PDCLeska/Backgammon/art/olive.png

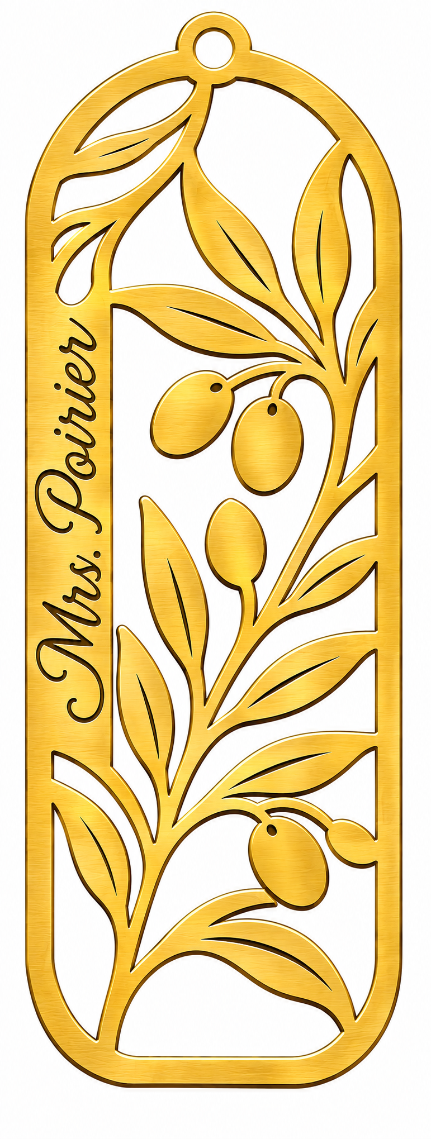
art/olive.png
