PDCLeska/Backgammon/art/sunflower.png

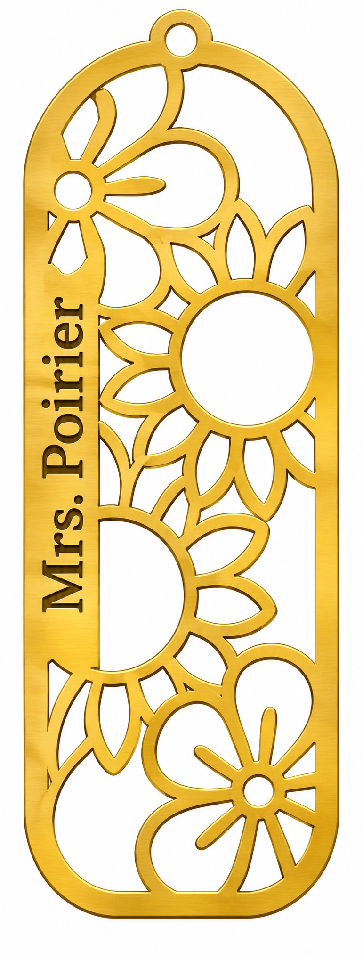
art/sunflower.png
