PDCLeska/Backgammon/art/back_map.png

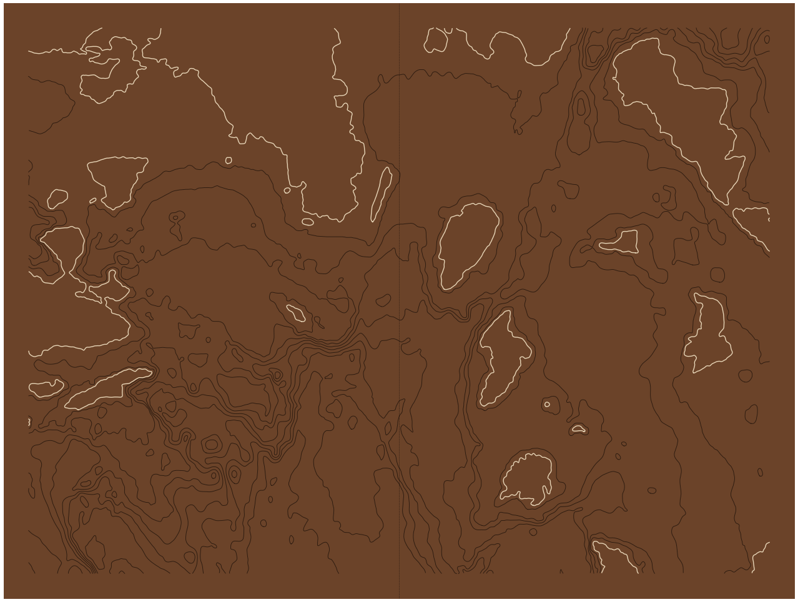
art/back_map.png
