PDCLeska/Backgammon/art/bookmark.png

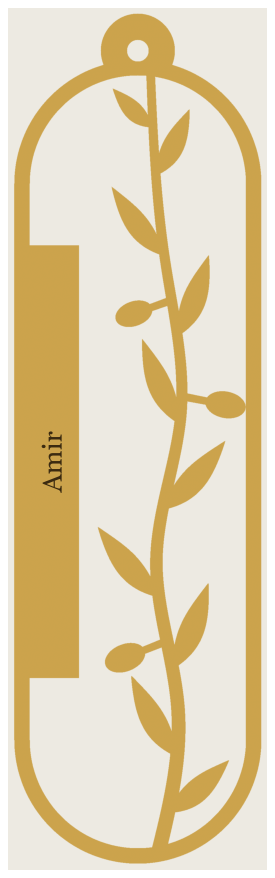
art/bookmark.png
