PDCLeska/Backgammon/art/chamfer_offset.png

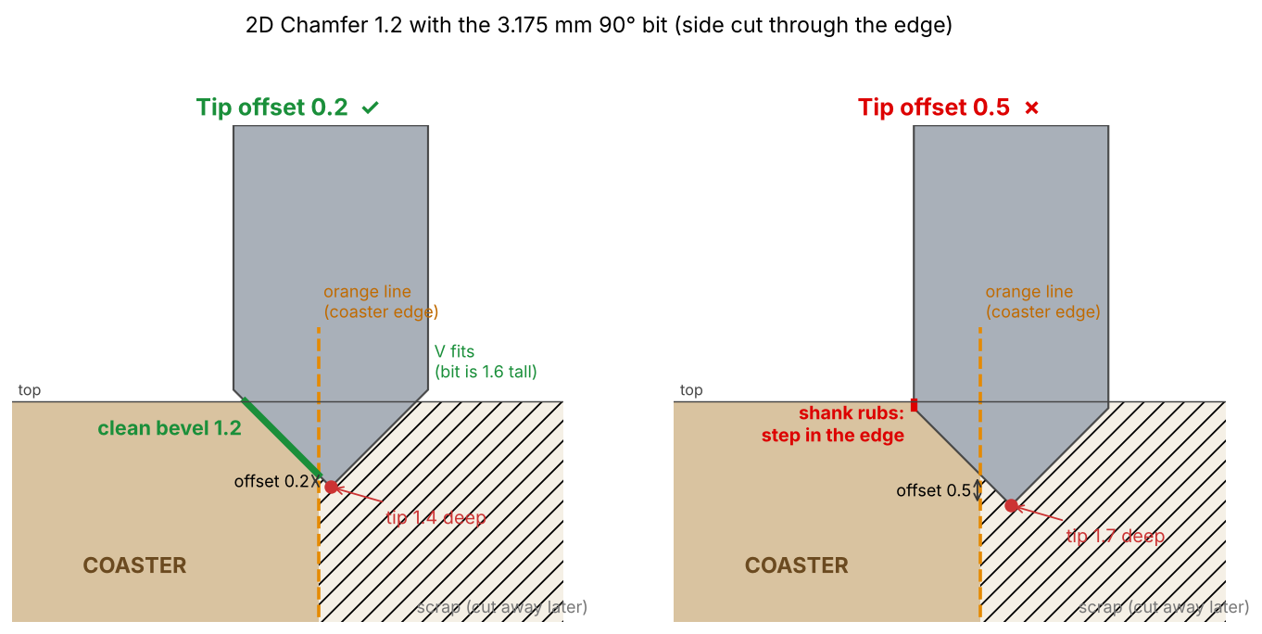
art/chamfer_offset.png
