PDCLeska/Backgammon/art/coaster_map.png

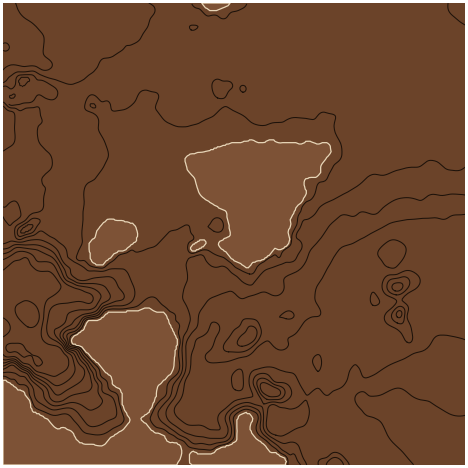
art/coaster_map.png
