PDCLeska/Backgammon/art/pintest.png

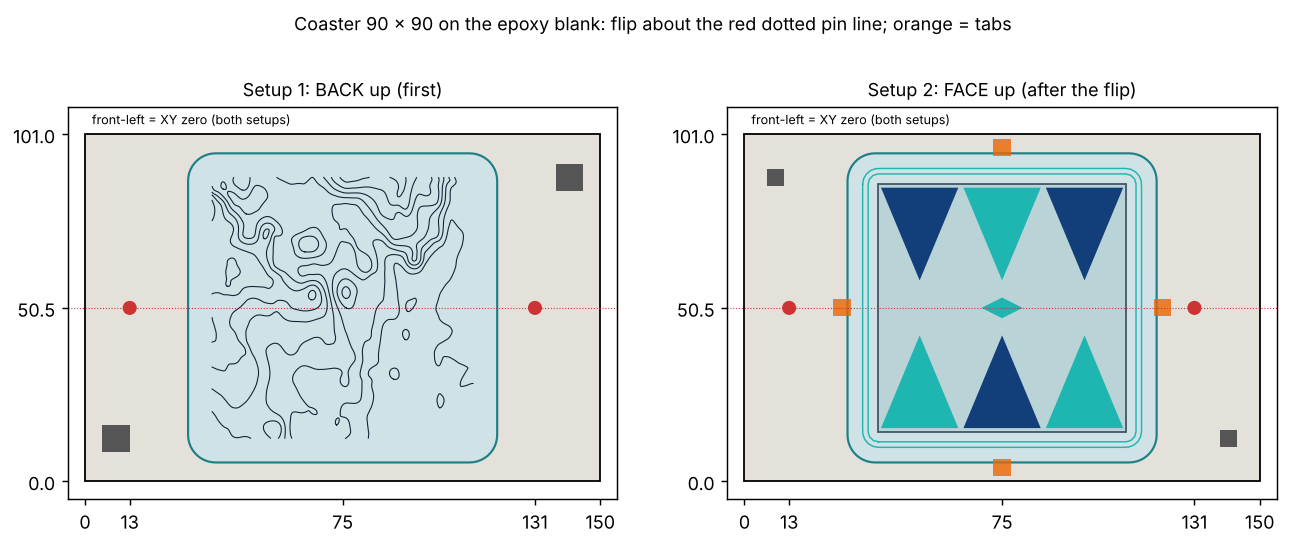
art/pintest.png
