PDCLeska/Backgammon/export/bookmarks/sunflower_on_plate.png

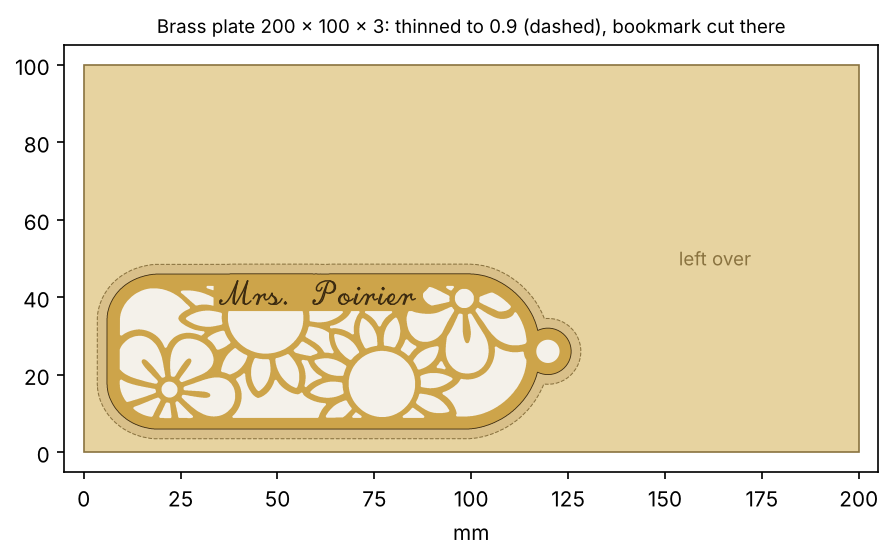
export/bookmarks/sunflower_on_plate.png
