PDCLeska/Backgammon/export/bookmarks/bookmark_sunflower.step

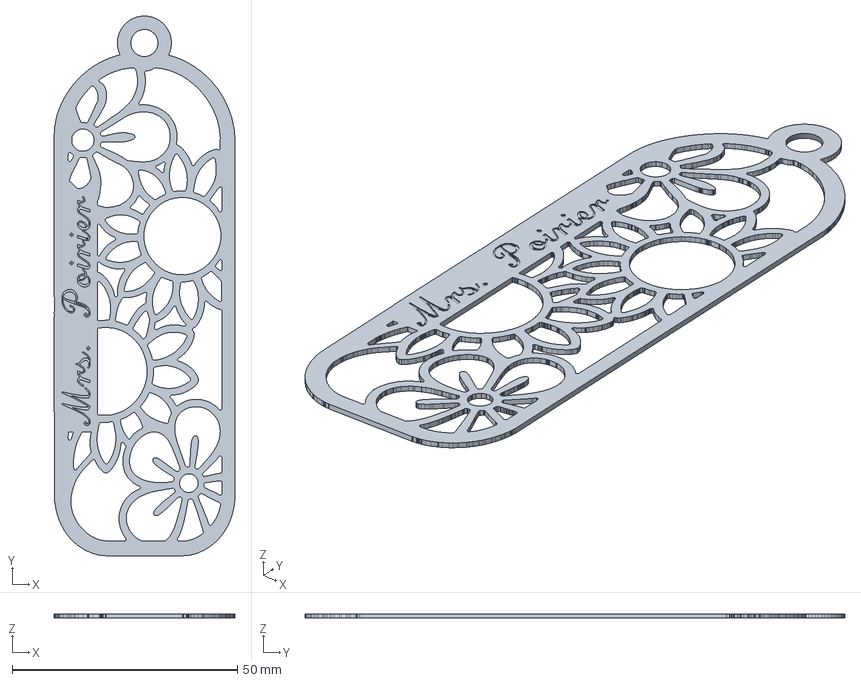
[picture p9: CAD file, 2026-11-07]
export/bookmarks/bookmark_sunflower.step
40.1 x 119.8 x 0.9 mm
