PDCLeska/Backgammon/export/pintest.step

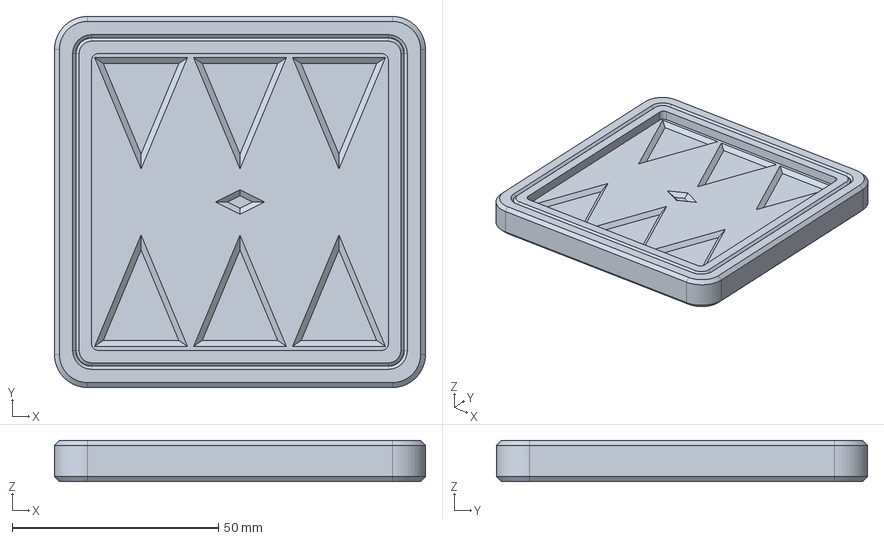
[picture p10: CAD file, 2026-11-07]
export/pintest.step
90.0 x 90.0 x 10.0 mm
