PDCLeska/Backgammon/export/bookmarks/sunflower_on_plate.dxf

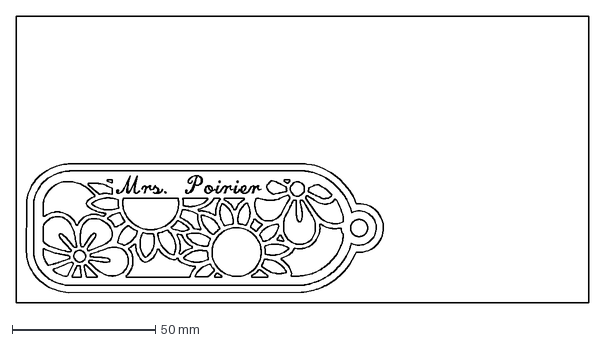
[picture p11: CAD file, 2026-11-07]
export/bookmarks/sunflower_on_plate.dxf
200.0 x 100.0 mm
