PDCLeska/Backgammon/export/pintest_2_face.dxf

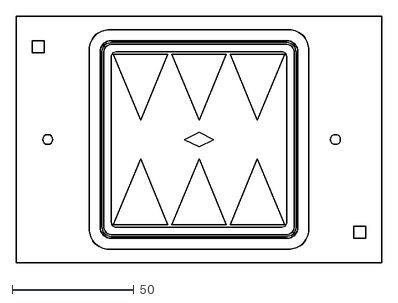
[picture p12: CAD file, 2026-11-07]
export/pintest_2_face.dxf
150.0 x 101.0
