PDCLeska/Backgammon/export/pintest_1_back.dxf

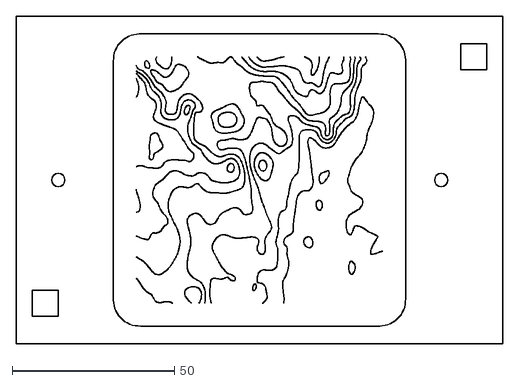
[picture p13: CAD file, 2026-11-07]
export/pintest_1_back.dxf
150.0 x 101.0
