PDCLeska/Backgammon/export/pintest_pins.dxf

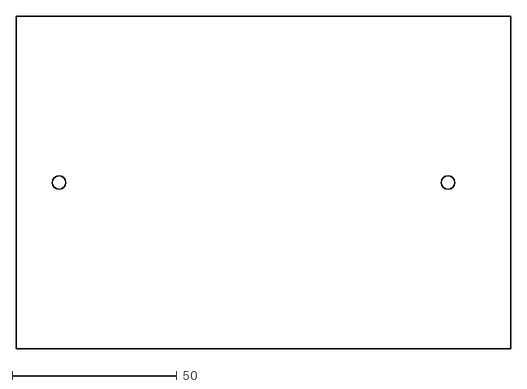
[picture p14: CAD file, 2026-11-07]
export/pintest_pins.dxf
150.0 x 101.0
