PDCLeska/Backgammon/export/bookmark.step

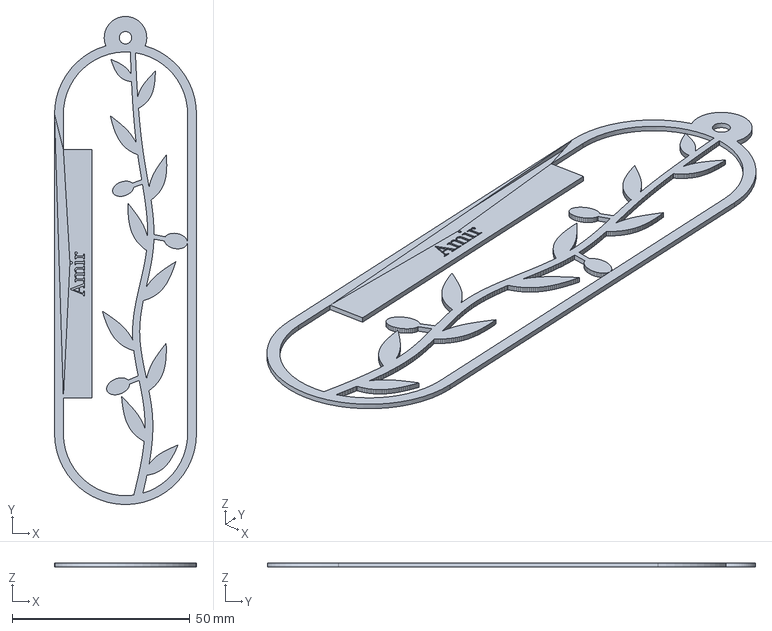
[picture p15: CAD file, 2026-11-07]
export/bookmark.step
40.0 x 137.5 x 1.00 mm
