PDCLeska/Backgammon/export/coaster_back.dxf

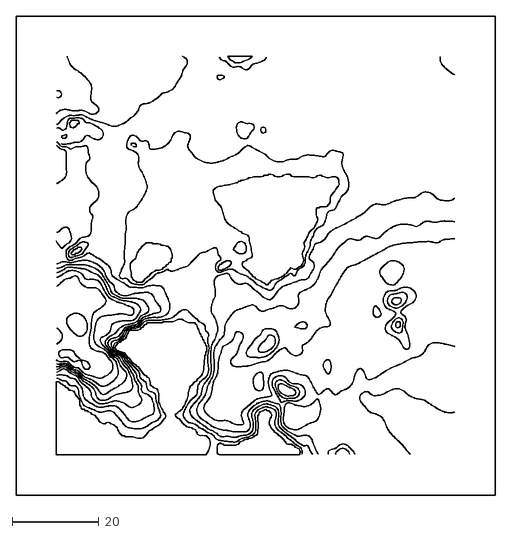
[picture p16: CAD file, 2026-10-28]
export/coaster_back.dxf
110.5 x 110.5
