PDCLeska/Backgammon/export/coaster.step

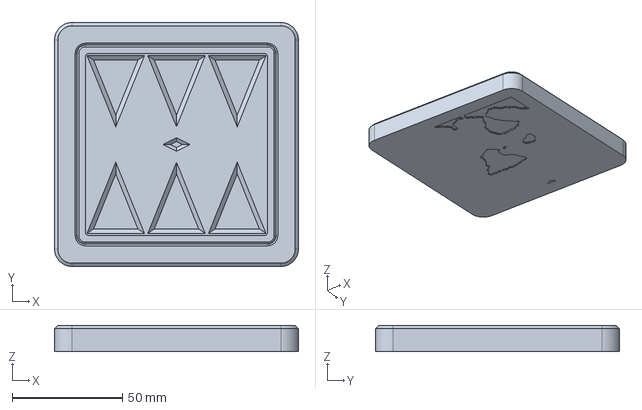
[picture p17: CAD file, 2026-10-28]
export/coaster.step
110.5 x 110.5 x 12.0 mm
