PDCLeska/Backgammon/export/coaster_top.dxf

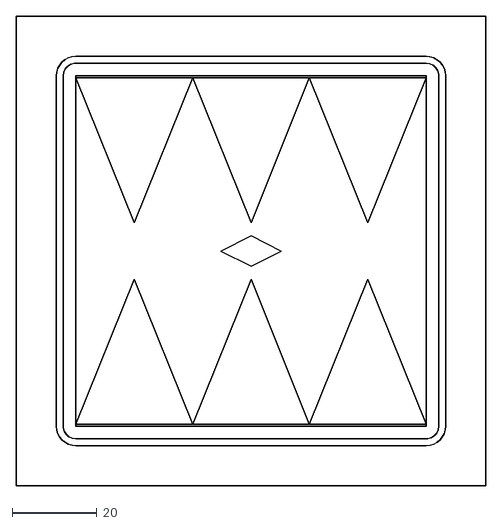
[picture p18: CAD file, 2026-10-28]
export/coaster_top.dxf
110.5 x 110.5
