PDCLeska/Backgammon/export/bg_back_left.dxf

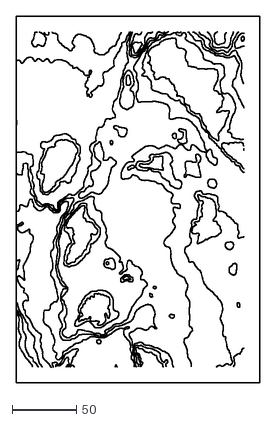
[picture p19: CAD file, 2026-10-28]
export/bg_back_left.dxf
190.0 x 286.0
