PDCLeska/Backgammon/export/bg_back_right.dxf

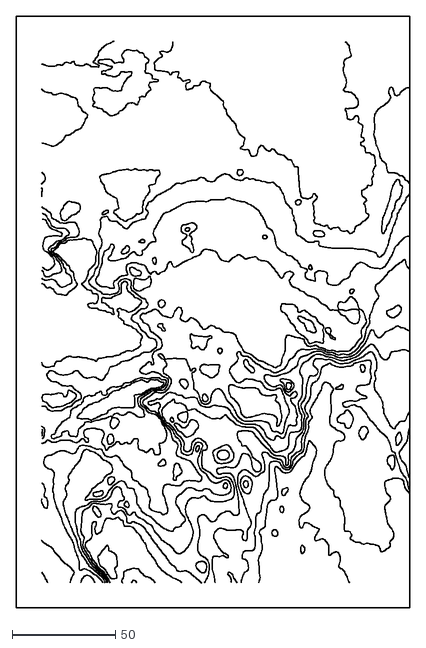
[picture p20: CAD file, 2026-10-28]
export/bg_back_right.dxf
190.0 x 286.0
