PDCLeska/Backgammon/export/bg_checker.step

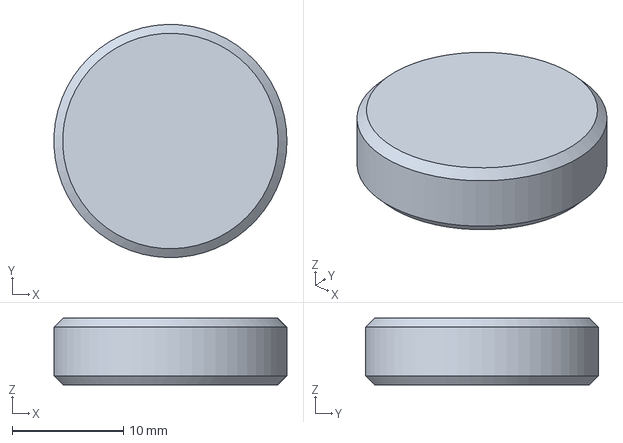
[picture p21: CAD file, 2026-10-28]
export/bg_checker.step
21.0 x 21.0 x 6.00 mm
