PDCLeska/Backgammon/export/bg_points_left.dxf

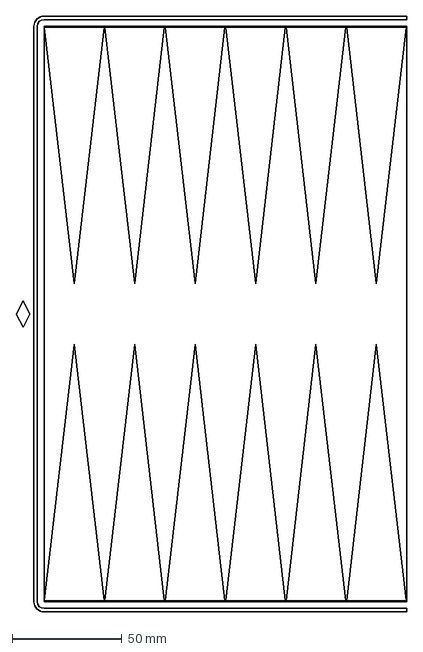
[picture p22: CAD file, 2026-10-28]
export/bg_points_left.dxf
177.6 x 271.2 mm
