PDCLeska/Backgammon/export/bg_half_right.step

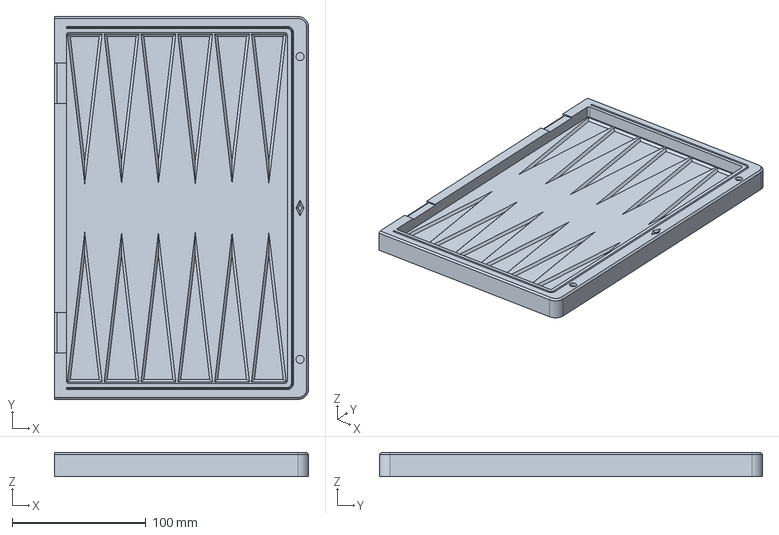
[picture p23: CAD file, 2026-10-28]
export/bg_half_right.step
190.0 x 286.0 x 18.0 mm
