PDCLeska/Backgammon/export/bg_points_right.dxf

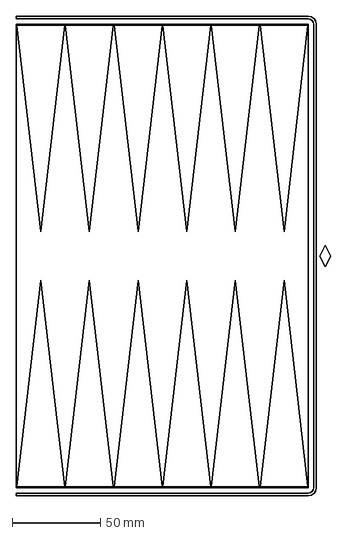
[picture p24: CAD file, 2026-10-28]
export/bg_points_right.dxf
177.6 x 271.2 mm
