PDCLeska/Backgammon/export/bg_inlay_sheet.dxf

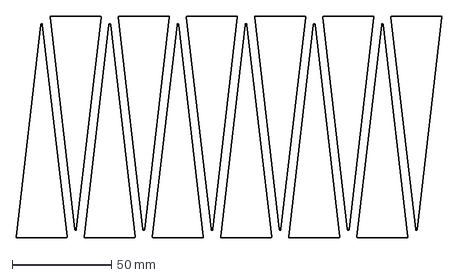
[picture p25: CAD file, 2026-10-28]
export/bg_inlay_sheet.dxf
215.0 x 111.8 mm
