PDCLeska/Backgammon/(list of files, cad)

Other CAD files:
export/bg_half_left.step
export/bg_checker.stl
export/bg_half_left.stl
export/bg_half_right.stl
export/bookmark.dxf
export/bookmark.stl
export/bookmarks/bookmark_sunflower.dxf
export/bookmarks/bookmark_sunflower.stl
export/coaster.stl
export/pintest.stl
