PDCLeska/Backgammon/art/pintest_setup.png

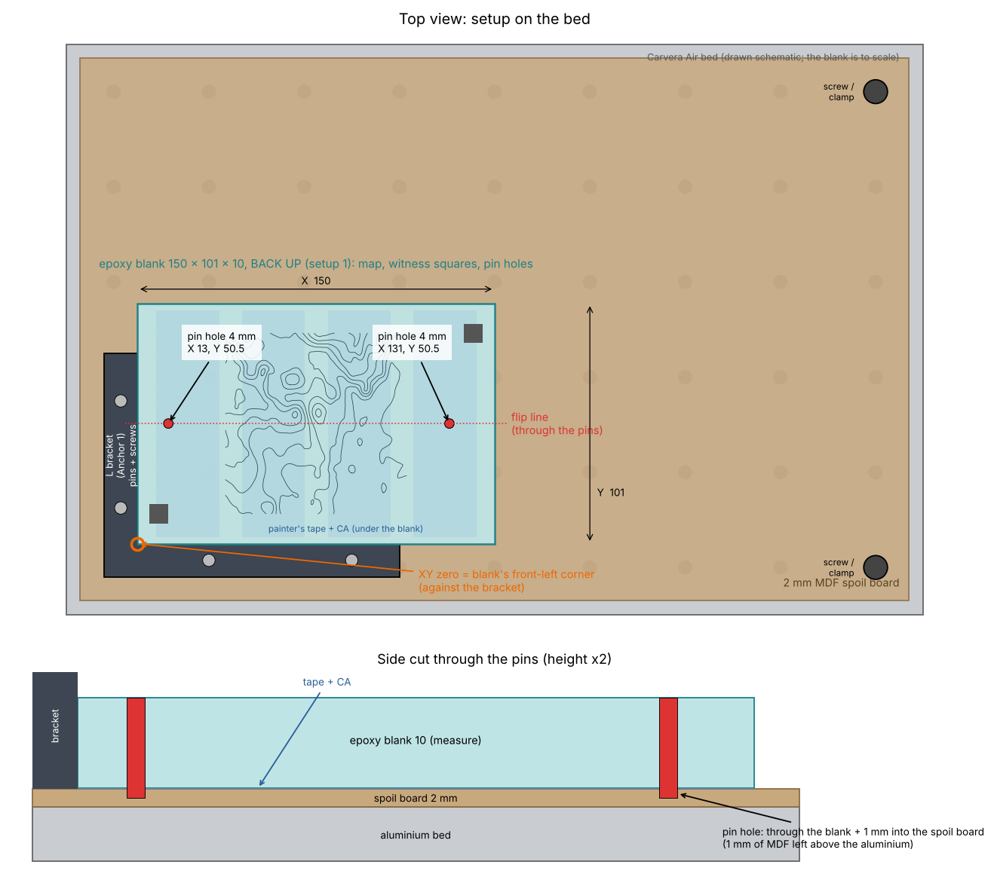
art/pintest_setup.png
