PDCLeska/Backgammon/(commit log)

2026-10-28 Backgammon board v0: folding two-half draft for the Carvera Air, checks, viewer
    [bg_checker.step, bg_checker.stl, bg_half_left.step, bg_half_left.stl, bg_half_right.step, bg_half_right.stl, bg_inlays_dark.step, bg_inlays_dark.stl]
2026-10-28 Points as wood inlays: rounded pocket corners, fitted pieces (0.08 glue gap), nested cutting sheet per wood, facing order
    [bg_checker.step, bg_half_left.step, bg_half_left.stl, bg_half_right.step, bg_half_right.stl, bg_inlay_sheet.dxf, bg_inlay_sheet.step, bg_inlay_sheet.stl]
2026-10-28 Walnut board, maple + padauk points; fix back-row point pockets cut below the floor; check inlay depth
    [bg_checker.step, bg_half_left.step, bg_half_left.stl, bg_half_right.step, bg_half_right.stl, bg_inlay_sheet.dxf, bg_inlay_sheet.step]
2026-10-28 Checkers 21 mm: 6 in a row on a point, 10 mm left in the middle
    [bg_checker.step, bg_checker.stl, bg_half_left.step, bg_half_right.step, bg_inlay_sheet.dxf, bg_inlay_sheet.step]
2026-10-28 Points as a V-carve inlay (90 deg V-bit, sharp tips): V pockets, plugs with skirts on a sheet per wood, point outlines DXF for the inlay software; tools list
    [bg_checker.step, bg_half_left.step, bg_half_left.stl, bg_half_right.step, bg_half_right.stl, bg_inlay_sheet.step, bg_inlay_sheet.stl, bg_plug_sheet.step]
2026-10-28 Points as epoxy fill (turquoise + deep blue) in V-carved pockets; look from Amir's photo: rim line 3 mm off the field wall, rim diamonds, chamfered edges
    Plug sheet dropped. Outer side rim 16 (half 190 wide) for the line, 6 mm magnets and diamond; checks for the walnut
    left round them, the two-pour gap, and the field corners the O-flute can't face.
    [bg_checker.step, bg_half_left.step, bg_half_left.stl, bg_half_right.step, bg_half_right.stl, bg_plug_sheet.step, bg_plug_sheet.stl, bg_points_left.dxf]
2026-10-28 Magnets: 6 x 3, Amir has them
2026-10-28 Back: sea-floor contour map (Saronic Gulf to Syros) across both backs; build order: back first, blue pour first, outline last
    art/topo.py turns GMRT depth data into contours (coast + every 100 m), fits them to the two backs, splits them at
    the hinge and writes a DXF per half; the viewer shows them (Back view). Check: wood under the points with the
    engraving. Docs: holding without scratches, the new order.
    [bg_back_left.dxf, bg_back_right.dxf]
2026-10-28 Coffee coaster: the practice piece with every board technique (points, two pours, rim line, diamond, facing; back: Aegina map, land recessed, depth lines lasered)
    cad/coaster.py (model, check, export: STEP/STL, top + back DXF), art/coaster_map.py (land clipped exactly at the map
    edge, sea lines every 50 m), viewer: ?model=coaster (own data dir, no fold controls).
    [coaster.step, coaster.stl, coaster_back.dxf, coaster_top.dxf]
2026-11-04 Ready for the laptop: map data and requirements in the repo, setup steps, wood cut list and basic first steps
2026-11-04 Pin-flip test plate: small board on the face, pins outside it, sea-floor map on the back
    Claude-Session: https://claude.ai/code/session_01XSb2aWefqFRn1JEE6C3uQR
    [pintest.step, pintest.stl, pintest_1_back.dxf, pintest_2_face.dxf]
2026-11-04 Pin test: pins 1 mm into the 2 mm spoil board (no fixture plate)
    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
    [pintest.step, pintest_1_back.dxf, pintest_2_face.dxf]
2026-11-04 Pin test: back map moved to open sea (no islands, depth lines every 100 m)
    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
    [pintest.step, pintest_1_back.dxf, pintest_2_face.dxf]
2026-11-04 Pin test: 4 mm holes for the Carvera Air's own dowel pins, pins-only DXF for the CAM
    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
    [pintest.step, pintest.stl, pintest_1_back.dxf, pintest_2_face.dxf, pintest_pins.dxf]
2026-11-04 Pin test: blank measured 150 x 101, pins on the true centre line (Y 50.5)
    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
    [pintest.step, pintest.stl, pintest_1_back.dxf, pintest_2_face.dxf, pintest_pins.dxf]
2026-11-04 Pin test: drawing of the setup on the bed (art/pintest_setup.png)
    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
2026-11-04 Coaster on the epoxy blank: 90 x 90, pins, open-sea map, V-carve only, outline with tabs
    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
    [pintest.step, pintest.stl, pintest_1_back.dxf, pintest_2_face.dxf, pintest_pins.dxf]
2026-11-04 Coaster: back edge chamfered 1.5 too (outline in the back file)
    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
    [pintest.step, pintest.stl, pintest_1_back.dxf, pintest_2_face.dxf, pintest_pins.dxf]
2026-11-04 Coaster: all on the 1/8" collet today (set's small V-bit: V-cuts 1.4, chamfers 1.2)
    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
    [pintest.step, pintest.stl, pintest_1_back.dxf, pintest_2_face.dxf, pintest_pins.dxf]
2026-11-05 Docs: 6 mm collet + bits on hand, used from the next project
    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
2026-11-05 Drawing: chamfer tip offset 0.2 vs 0.5 with the 3.175 V-bit
    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
2026-11-05 Coaster: rim line centre layer; pin holes 4.1 x 2.5 into the spoil; notes from side 1
    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
    [pintest.step, pintest_1_back.dxf, pintest_2_face.dxf, pintest_pins.dxf]
2026-11-07 Bookmark (capability test): brass, ring tab, name band, olive branch cut through; checks for one piece, tool reach and thin brass; DXF / STEP / STL; in the viewer
    [bookmark.dxf, bookmark.step, bookmark.stl]
2026-11-07 Sunflower bookmark traced from Amir's picture: 0.8 mm brass, lines thinned to ~1.5, name in Edwardian Script, placed on his 100 x 150 plate with room for a second try; viewer ?model=bookmarks
    [bookmark.dxf, bookmark.step, bookmark.stl, bookmark_sunflower.dxf, bookmark_sunflower.step, bookmark_sunflower.stl, sunflower_on_plate.dxf]
2026-11-07 Handoff for the laptop session: docs/HANDOFF.md (the sunflower bookmark, how to cut it, what's open); CLAUDE.md points to it
2026-11-07 Sunflower bookmark: 3 mm brass on a 100 x 200 plate; DXF as closed shapes (47 cut-outs, outline, letters); name outlines saved for computers without the font
    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
    [bookmark_sunflower.dxf, bookmark_sunflower.step, bookmark_sunflower.stl, sunflower_on_plate.dxf]
2026-11-07 Sunflower bookmark: 6 mm string hole for the 2.6 mm cord (bigger tab), bookmark in the plate's front-left corner
    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
    [bookmark_sunflower.dxf, bookmark_sunflower.step, bookmark_sunflower.stl, sunflower_on_plate.dxf]
2026-11-07 Sunflower bookmark: plate 200 x 100, bookmark turned 90 deg (lying along X, tab right), front-left corner
    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
    [bookmark_sunflower.dxf, bookmark_sunflower.step, sunflower_on_plate.dxf]
2026-11-07 Sunflower bookmark: Amir's plan, thin the 3 mm plate to 0.8 where the bookmark goes (face layer), then cut it with the 1 mm bit
    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
    [bookmark_sunflower.dxf, bookmark_sunflower.step, bookmark_sunflower.stl, sunflower_on_plate.dxf]
2026-11-07 Sunflower bookmark: 0.9 mm thick (thinning pocket 2.1 deep)
    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
    [bookmark_sunflower.dxf, bookmark_sunflower.step, bookmark_sunflower.stl, sunflower_on_plate.dxf]
2026-11-07 Sunflower bookmark: name as single-line strokes (Hershey scriptc), engraved on line 0.15 deep
    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
    [bookmark_sunflower.dxf, bookmark_sunflower.step, sunflower_on_plate.dxf]
2026-11-07 Bookmark 3D model: extrude up so the engraved name is cut into it (the DXF was not affected)
    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
    [bookmark_sunflower.dxf, bookmark_sunflower.step, bookmark_sunflower.stl, sunflower_on_plate.dxf]
